jimmerson17/blanc-mask-model/Parts/BLANC.07.01 Filter Pad/Sample. View 1.jpeg

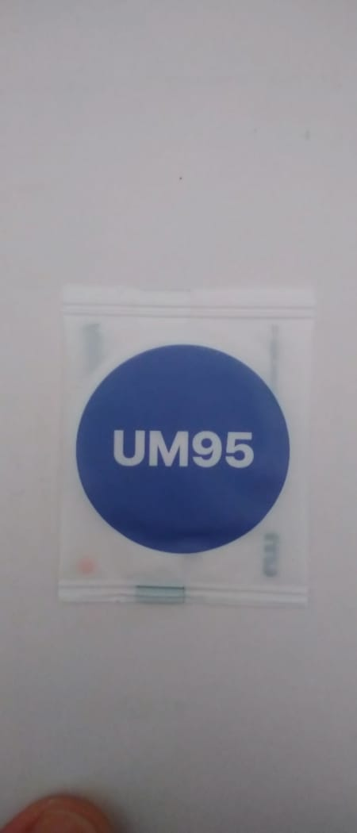
Parts/BLANC.07.01 Filter Pad/Sample. View 1.jpeg
