jimmerson17/blanc-mask-model/Product/BLANC.00.00 Blanc mask rev E.JPG

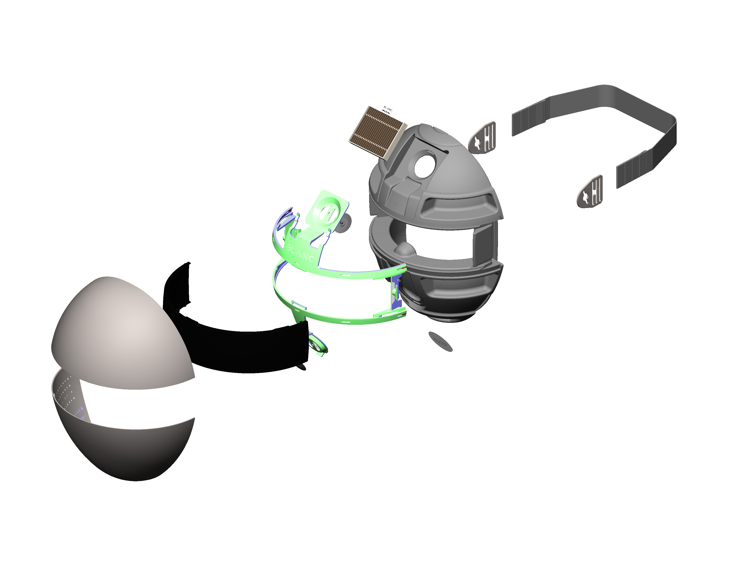
Product/BLANC.00.00 Blanc mask rev E.JPG
