jimmerson17/blanc-mask-model/Parts/BLANC.07.01 Filter Pad/Filter sample 2.jpg

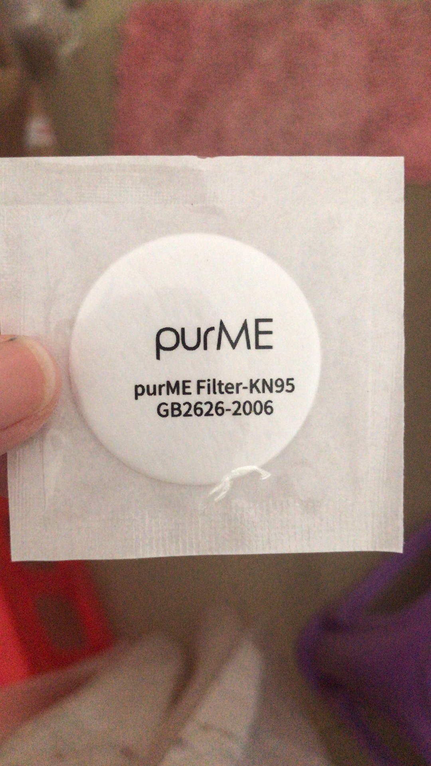
Parts/BLANC.07.01 Filter Pad/Filter sample 2.jpg
