jimmerson17/blanc-mask-model/Parts/BLANC.07.01 Filter Pad/Sample. View 2.jpeg

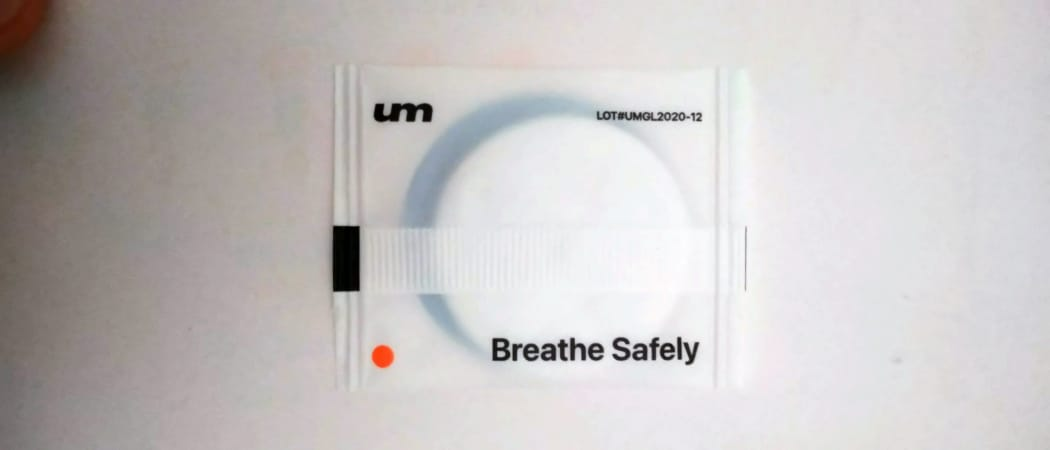
Parts/BLANC.07.01 Filter Pad/Sample. View 2.jpeg
