jimmerson17/blanc-mask-model/Parts/BLANC.02.01 Top shield/BLANC.02.01 Top shield rev F.STEP

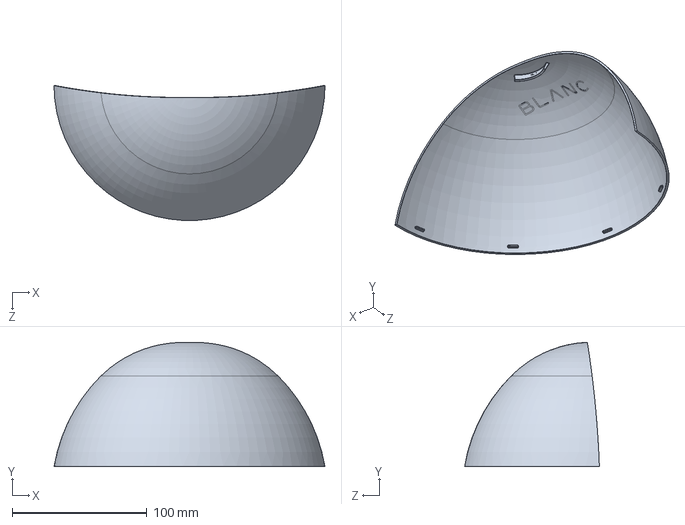
[picture p8: CAD file, 2022-05-24]
Parts/BLANC.02.01 Top shield/BLANC.02.01 Top shield rev F.STEP
201.2 x 92.4 x 100.1 mm
