jimmerson17/blanc-mask-model/Parts/BLANC.02.02 Bottom shield/BLANC.02.02 Bottom shield rev F.STEP

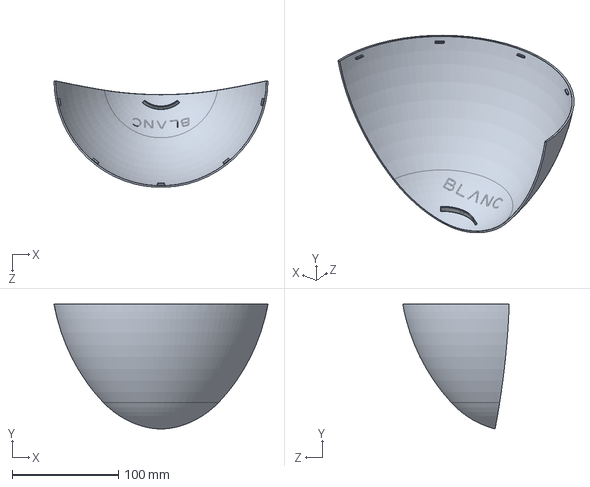
[picture p9: CAD file, 2022-05-24]
Parts/BLANC.02.02 Bottom shield/BLANC.02.02 Bottom shield rev F.STEP
201.2 x 117.4 x 100.1 mm
