jimmerson17/blanc-mask-model/Parts/BLANC.02.03 Visor/BLANC.02.03 Visor rev D.sldprt

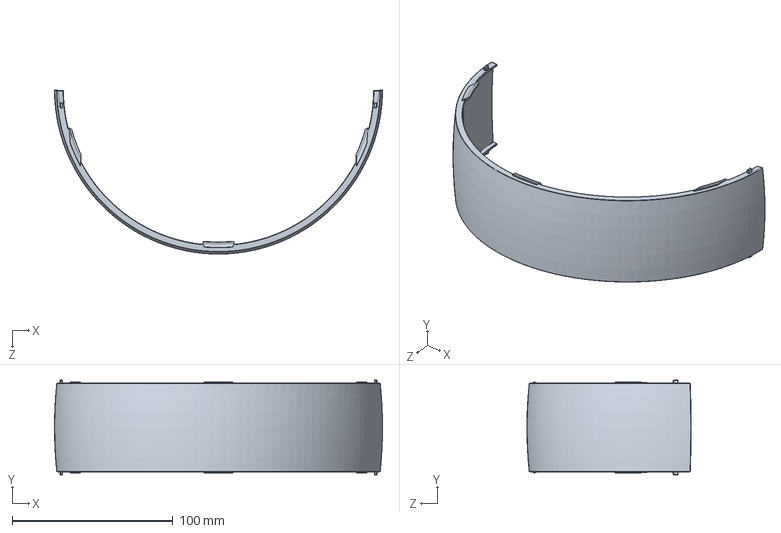
[picture p10: CAD file, 2022-05-24]
Parts/BLANC.02.03 Visor/BLANC.02.03 Visor rev D.sldprt
204.0 x 59.0 x 102.1 mm
