jimmerson17/blanc-mask-model/Parts/BLANC.03.01 Strap Holder/BLANC.03.01 Strap Holder rev D.sldprt

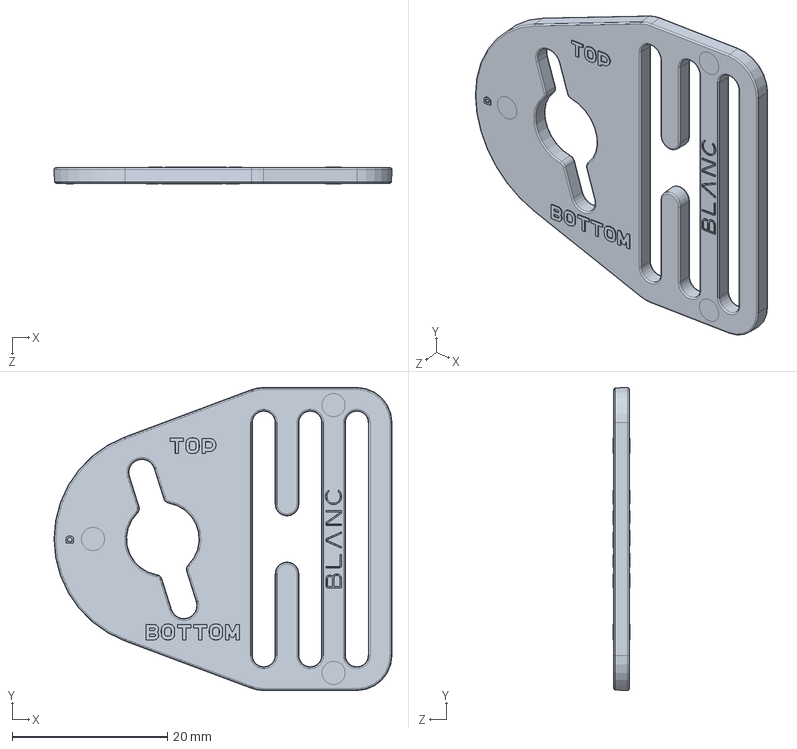
[picture p11: CAD file, 2022-05-24]
Parts/BLANC.03.01 Strap Holder/BLANC.03.01 Strap Holder rev D.sldprt
43.6 x 39.1 x 2.20 mm
