jimmerson17/blanc-mask-model/Parts/BLANC.03.02 Strap/BLANC.03.02 Strap rev C.sldprt

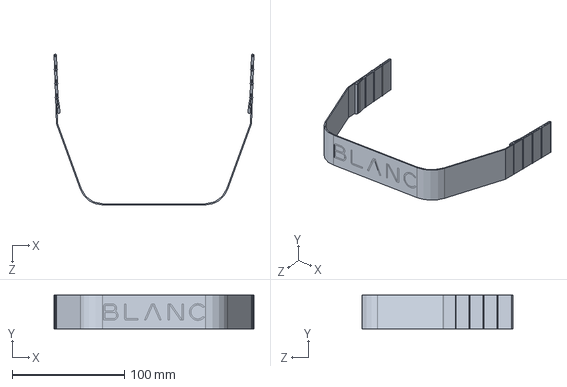
[picture p12: CAD file, 2022-05-24]
Parts/BLANC.03.02 Strap/BLANC.03.02 Strap rev C.sldprt
178.5 x 30.0 x 134.6 mm
