jimmerson17/blanc-mask-model/Parts/BLANC.04.01 Cuff/BLANC.04.01 Cuff rev H.sldprt

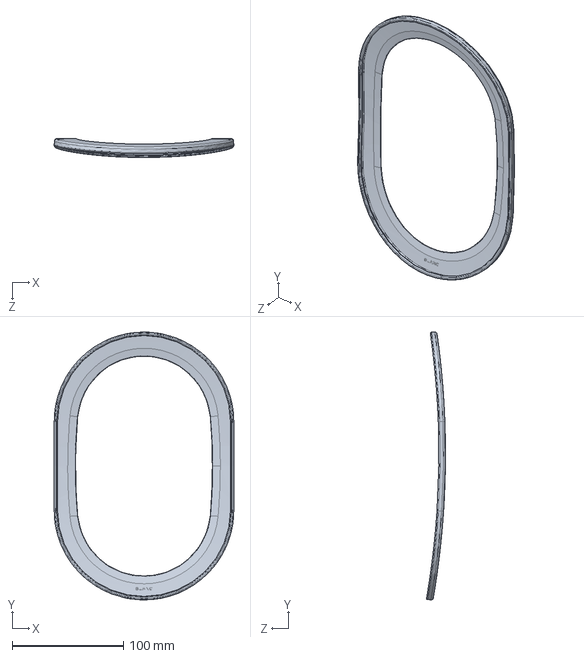
[picture p13: CAD file, 2022-05-24]
Parts/BLANC.04.01 Cuff/BLANC.04.01 Cuff rev H.sldprt
161.2 x 240.5 x 17.1 mm
