jimmerson17/blanc-mask-model/Parts/BLANC.05.01 HEPA Filter/BLANC.05.01 HEPA Filter rev C.sldprt

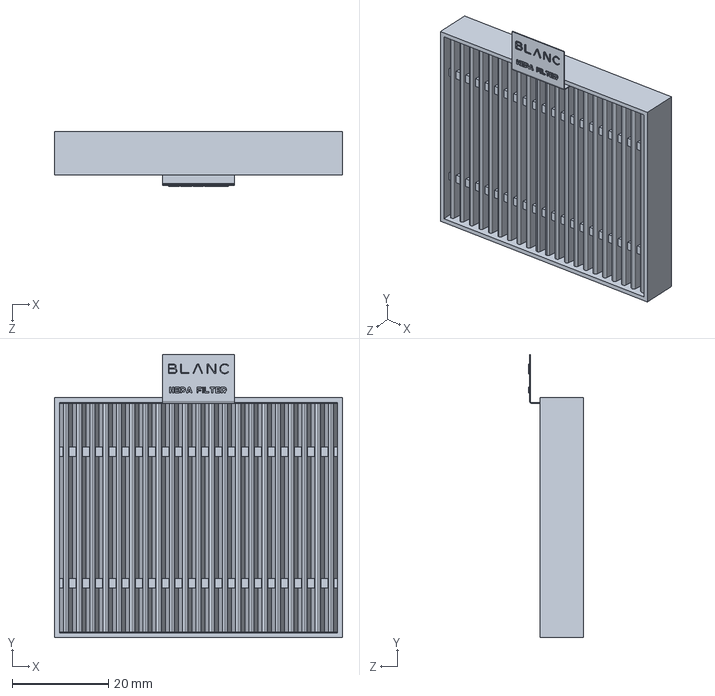
[picture p14: CAD file, 2022-05-24]
Parts/BLANC.05.01 HEPA Filter/BLANC.05.01 HEPA Filter rev C.sldprt
60.0 x 59.0 x 11.4 mm
