jimmerson17/blanc-mask-model/Parts/BLANC.06.01 Umbrella Valve/BLANC.06.01 Umbrella Valve rev D.STEP

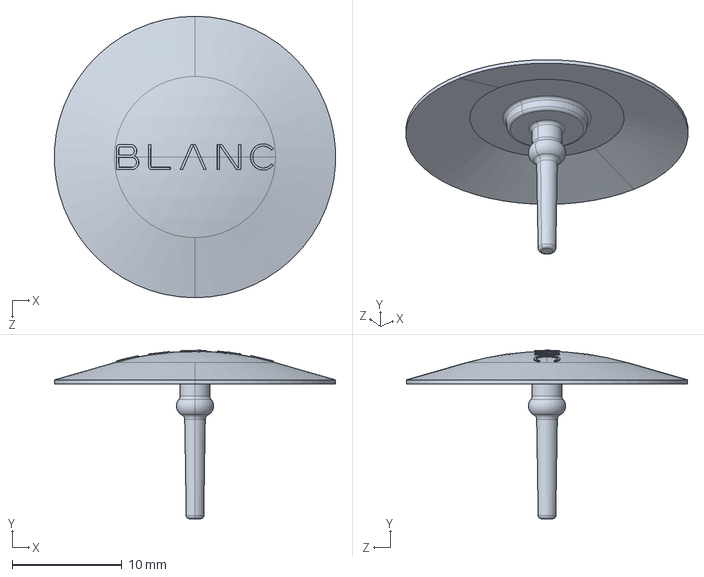
[picture p15: CAD file, 2022-05-24]
Parts/BLANC.06.01 Umbrella Valve/BLANC.06.01 Umbrella Valve rev D.STEP
25.6 x 15.3 x 25.6 mm
