jimmerson17/blanc-mask-model/(list of files, cad)

Other CAD files:
Parts/BLANC.07.01 Filter Pad/BLANC.07.01 Filter Pad. Layout 1.DWG
Parts/BLANC.02.03 Visor/BLANC.02.03 Visor rev E.STEP
Parts/BLANC.07.01 Filter Pad/BLANC.07.01 Filter Pad. Layout 2.DWG
Parts/BLANC.01.01 Body/BLANC.01.01 Body rev F.SLDDRW
Parts/BLANC.02.02 Bottom shield/BLANC.02.02 Bottom shield rev F.sldprt
Parts/BLANC.04.01 Cuff/BLANC.04.01 Cuff rev H.SLDDRW
Parts/BLANC.06.01 Umbrella Valve/BLANC.06.01 Umbrella Valve rev D.STL
Parts/BLANC.06.01 Umbrella Valve/BLANC.06.01 Umbrella Valve rev D.sldprt
Parts/BLANC.07.01 Filter Pad/BLANC.07.01 Filter Pad rev C.SLDPRT
Parts/BLANC.07.01 Filter Pad/BLANC.07.01 Filter Pad. Layout rev C.SLDDRW
