jimmerson17/blanc-mask-model/Parts/BLANC.07.01 Filter Pad/BLANC.07.01 Filter Pad. Layout 1.PDF

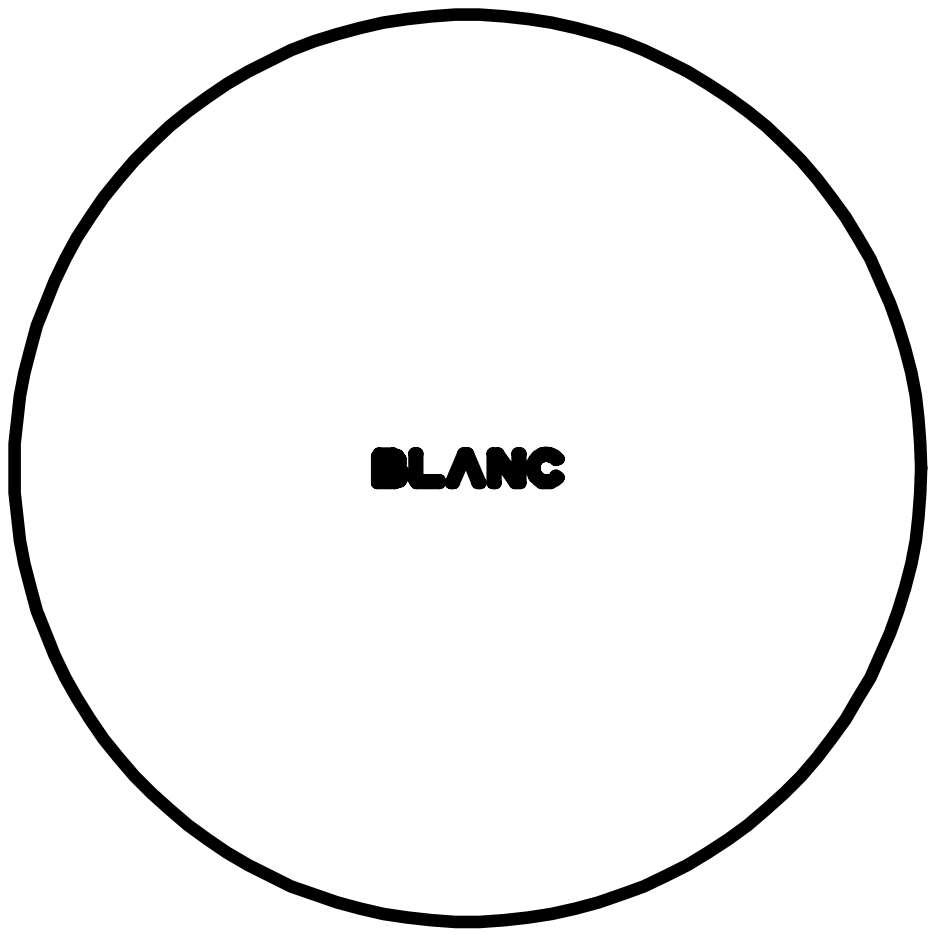
[picture p23: page 1]
