jimmerson17/blanc-mask-model/Parts/BLANC.07.01 Filter Pad/BLANC.07.01 Filter Pad. Layout 2.PDF

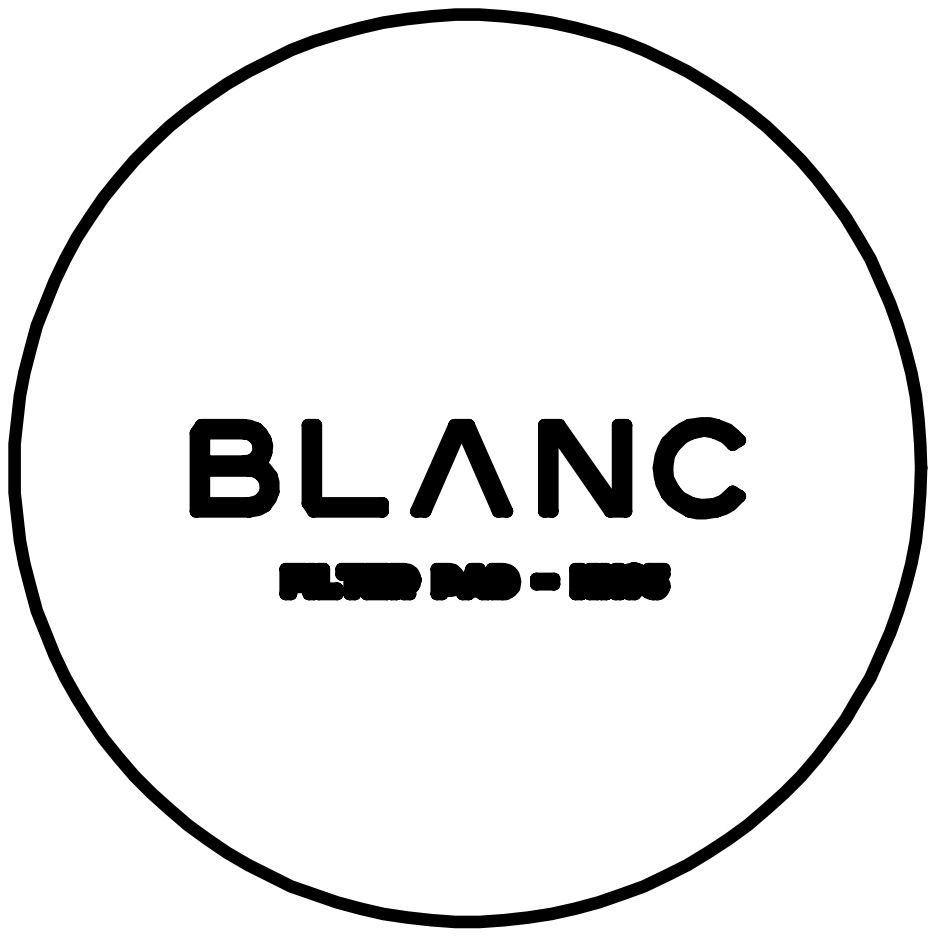
[picture p24: page 1]
