jimmerson17/blanc-mask-model/Product/BLANC.00.00 Blanc mask. Painting specificaion.pdf

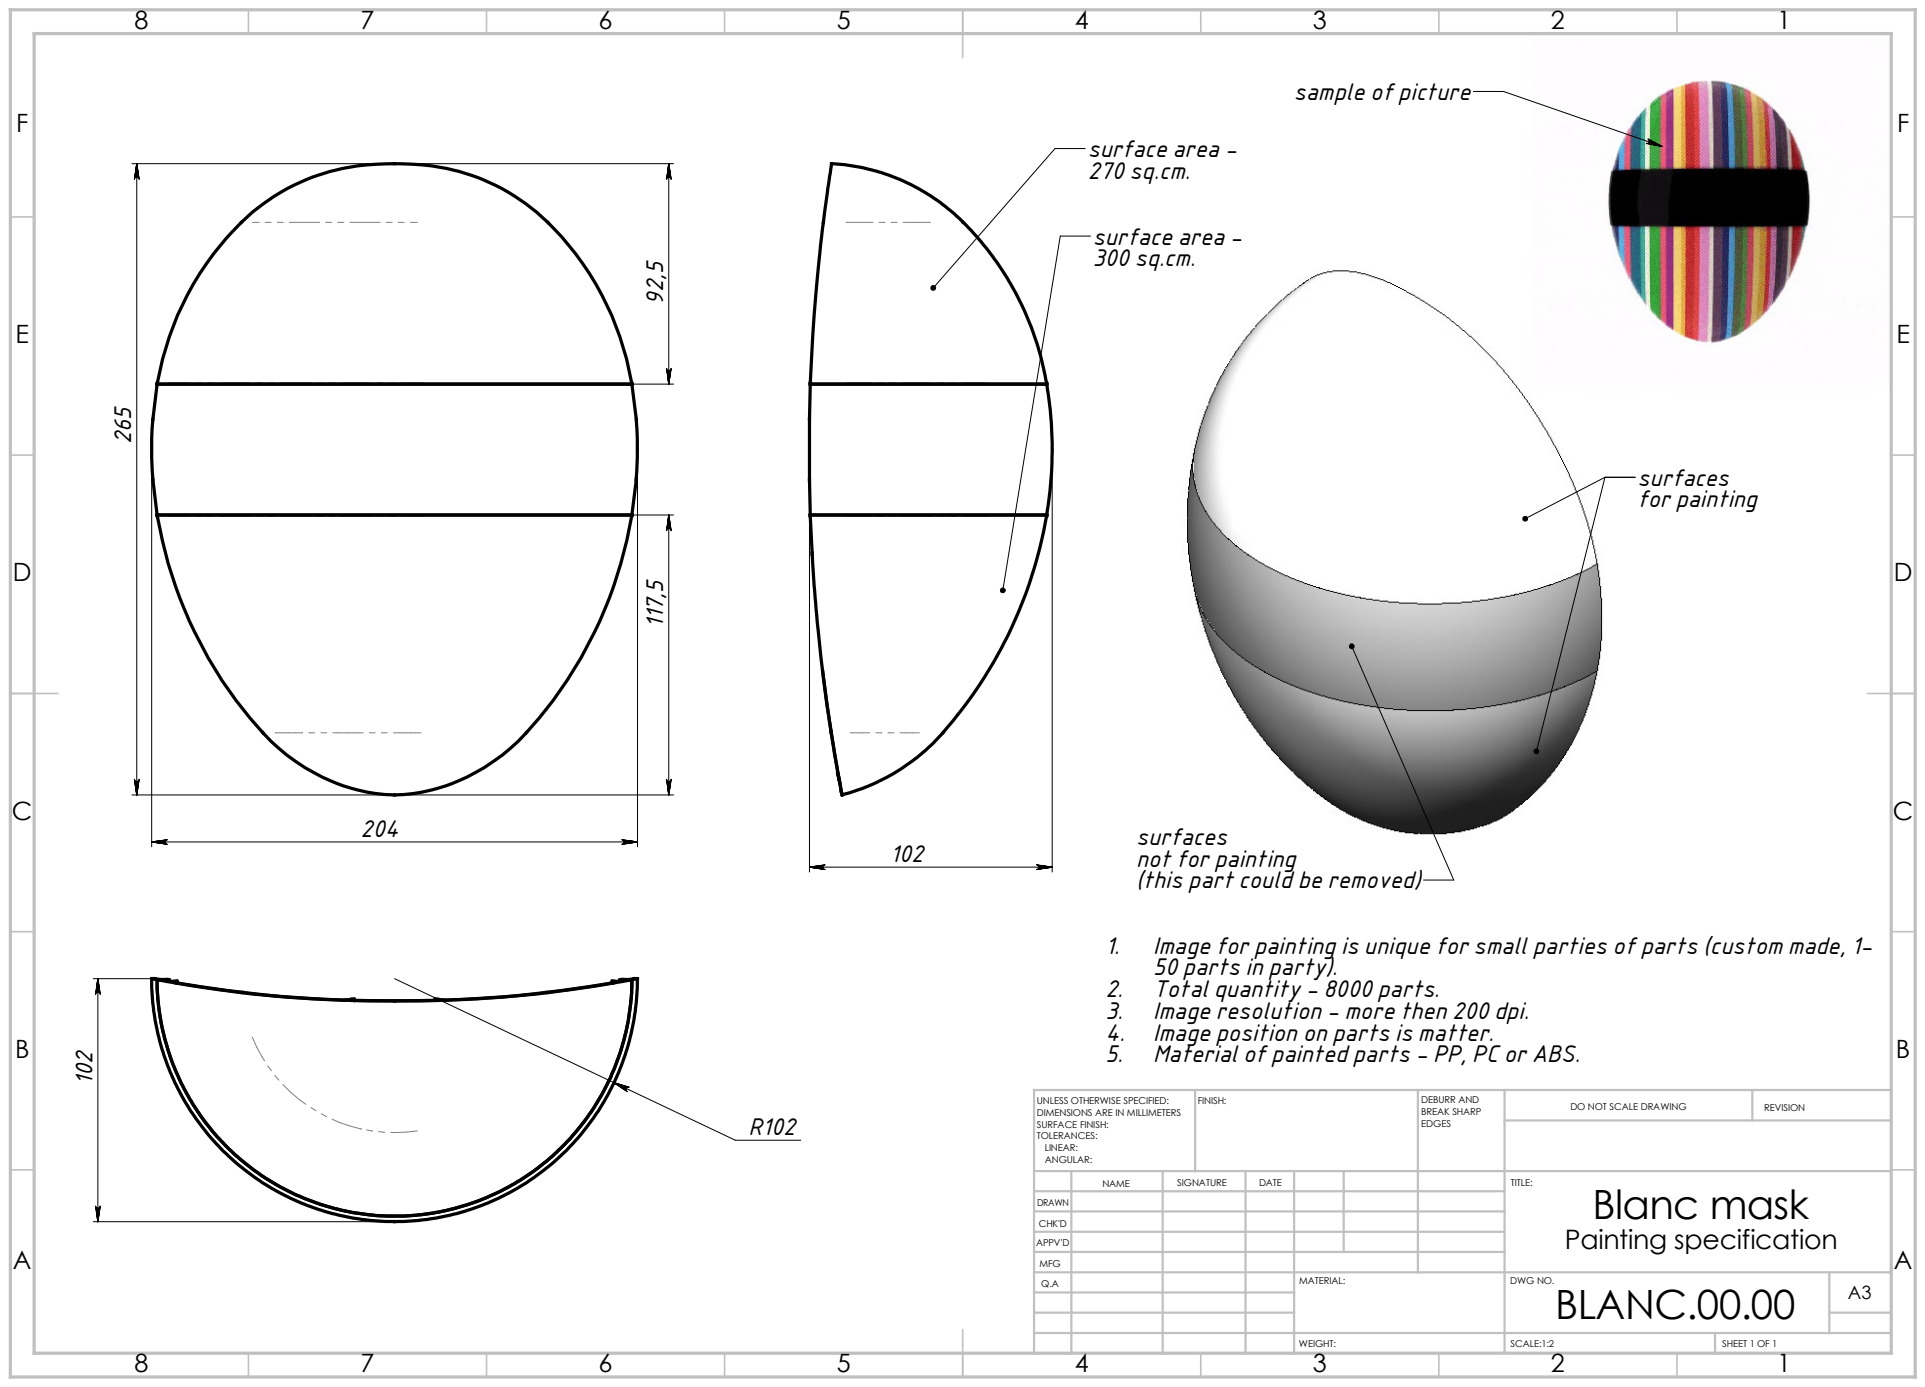
[picture p17: page 1]
102 ¹¹⁷,5 265; FINISH:; EDGES; NAME; SIGNATURE; DATE; DO NOT SCALE DRAWING; REVISION; TITLE:; SCALE:1:2; SHEET 1 OF 1; WEIGHT:; BREAK SHARP; Painting specification A A; DEBURR AND; Blanc mask; surface area - 300 sq.cm.; surface area - 270 sq.cm.; surfaces for painting

sample of picture

surfaces
not for painting
(this part could be removed)

1. Image for painting is unique for small parties of parts (custom made, 1-
50 parts in party).
2. Total quantity - 8000 parts.
3. Image resolution - more then 200 dpi.
4. Image position on parts is matter.
5. Material of painted parts - PP, PC or ABS.

UNLESS OTHERWISE SPECIFIED:
DIMENSIONS ARE IN MILLIMETERS
SURFACE FINISH:
TOLERANCES:
LINEAR:
ANGULAR:

MFG | | | | 1 DRAWN
CHK'D
APPV'D

Q.A | MATERIAL: | DWG NO. BLANC.00.00 | A3
