jimmerson17/blanc-mask-model/Parts/BLANC.01.01 Body/BLANC.01.01 Body rev F.pdf

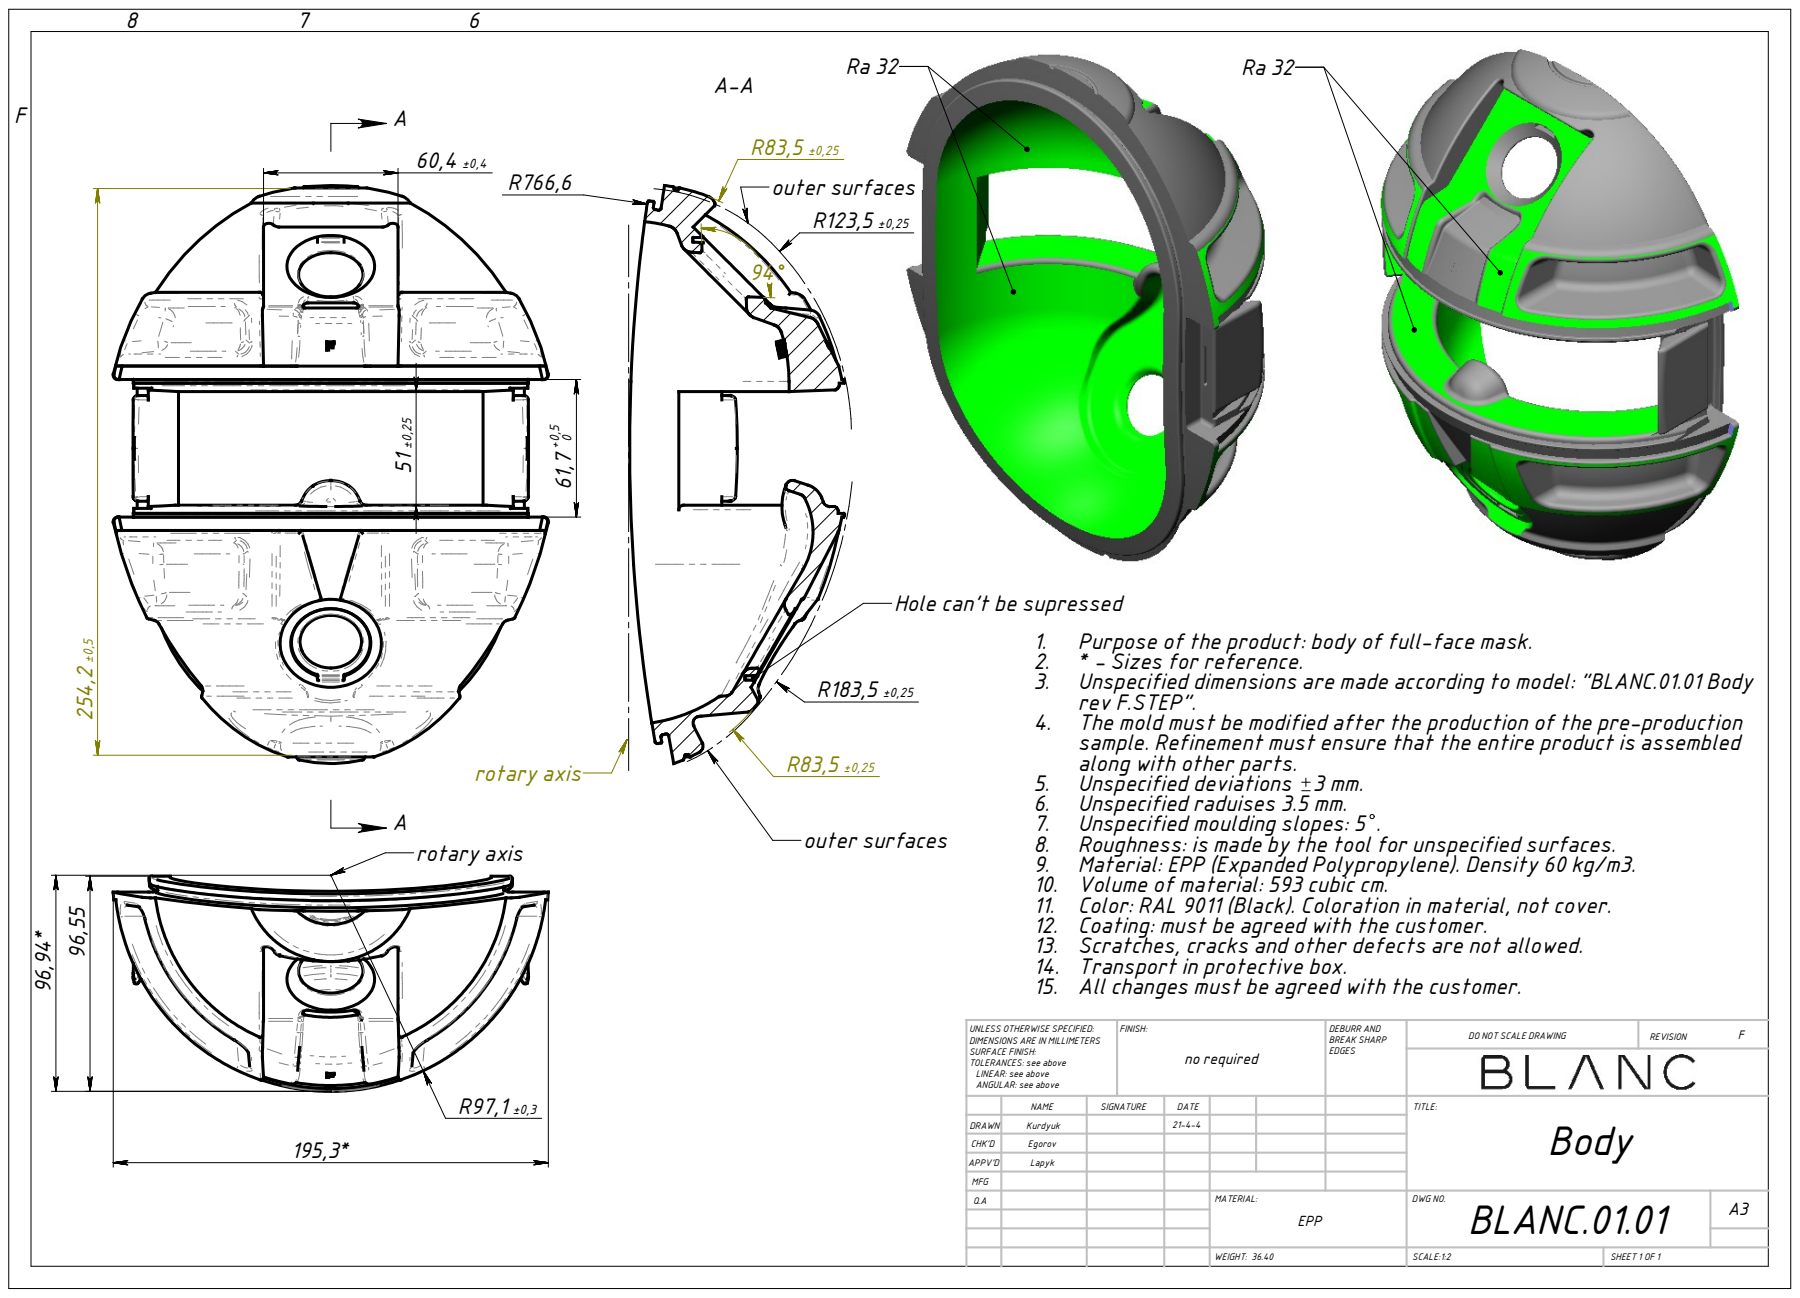
[picture p18: page 1]
WEIGHT: 36.40; FINISH:; EDGES; DO NOT SCALE DRAWING; REVISION; SCALE:1:2; SHEET 1 OF 1; no required; DEBURR AND BREAK SHARP; rotary axis; 195,3* ²⁵⁴,2 ±0,5; outer surfaces

Hole can't be supressed

1. Purpose of the product: body of full-face mask.
2. * - Sizes for reference.
3. Unspecified dimensions are made according to model: "BLANC.01.01 Body
rev F.STEP".
4. The mold must be modified after the production of the pre-production
sample. Refinement must ensure that the entire product is assembled
along with other parts.
5. Unspecified deviations 3 mm.
6. Unspecified raduises 3.5 mm.
7. Unspecified moulding slopes: 5 .
8. Roughness: is made by the tool for unspecified surfaces.
9. Material: EPP (Expanded Polypropylene). Density 60 kg/m3.
10. Volume of material: 593 cubic cm.
11. Color: RAL 9011 (Black). Coloration in material, not cover.
12. Сoating: must be agreed with the customer.
13. Scratches, cracks and other defects are not allowed.
14. Transport in protective box.
15. All changes must be agreed with the customer.

UNLESS OTHERWISE SPECIFIED:
DIMENSIONS ARE IN MILLIMETERS
SURFACE FINISH:
TOLERANCES: see above
LINEAR: see above
ANGULAR: see above

NAME | SIGNATURE | DATE | | | | TITLE: Body

DRAWN | Kurdyuk | | 21-4-4
CHK'D | Egorov
APPV'D | Lapyk
MFG
Q.A | | | | MATERIAL: EPP | DWG NO. BLANC.01.01 | A3
