jimmerson17/blanc-mask-model/Parts/BLANC.02.02 Bottom shield/BLANC.02.02 Bottom shield rev E.pdf

# Roughness scheme (color only for scheme)

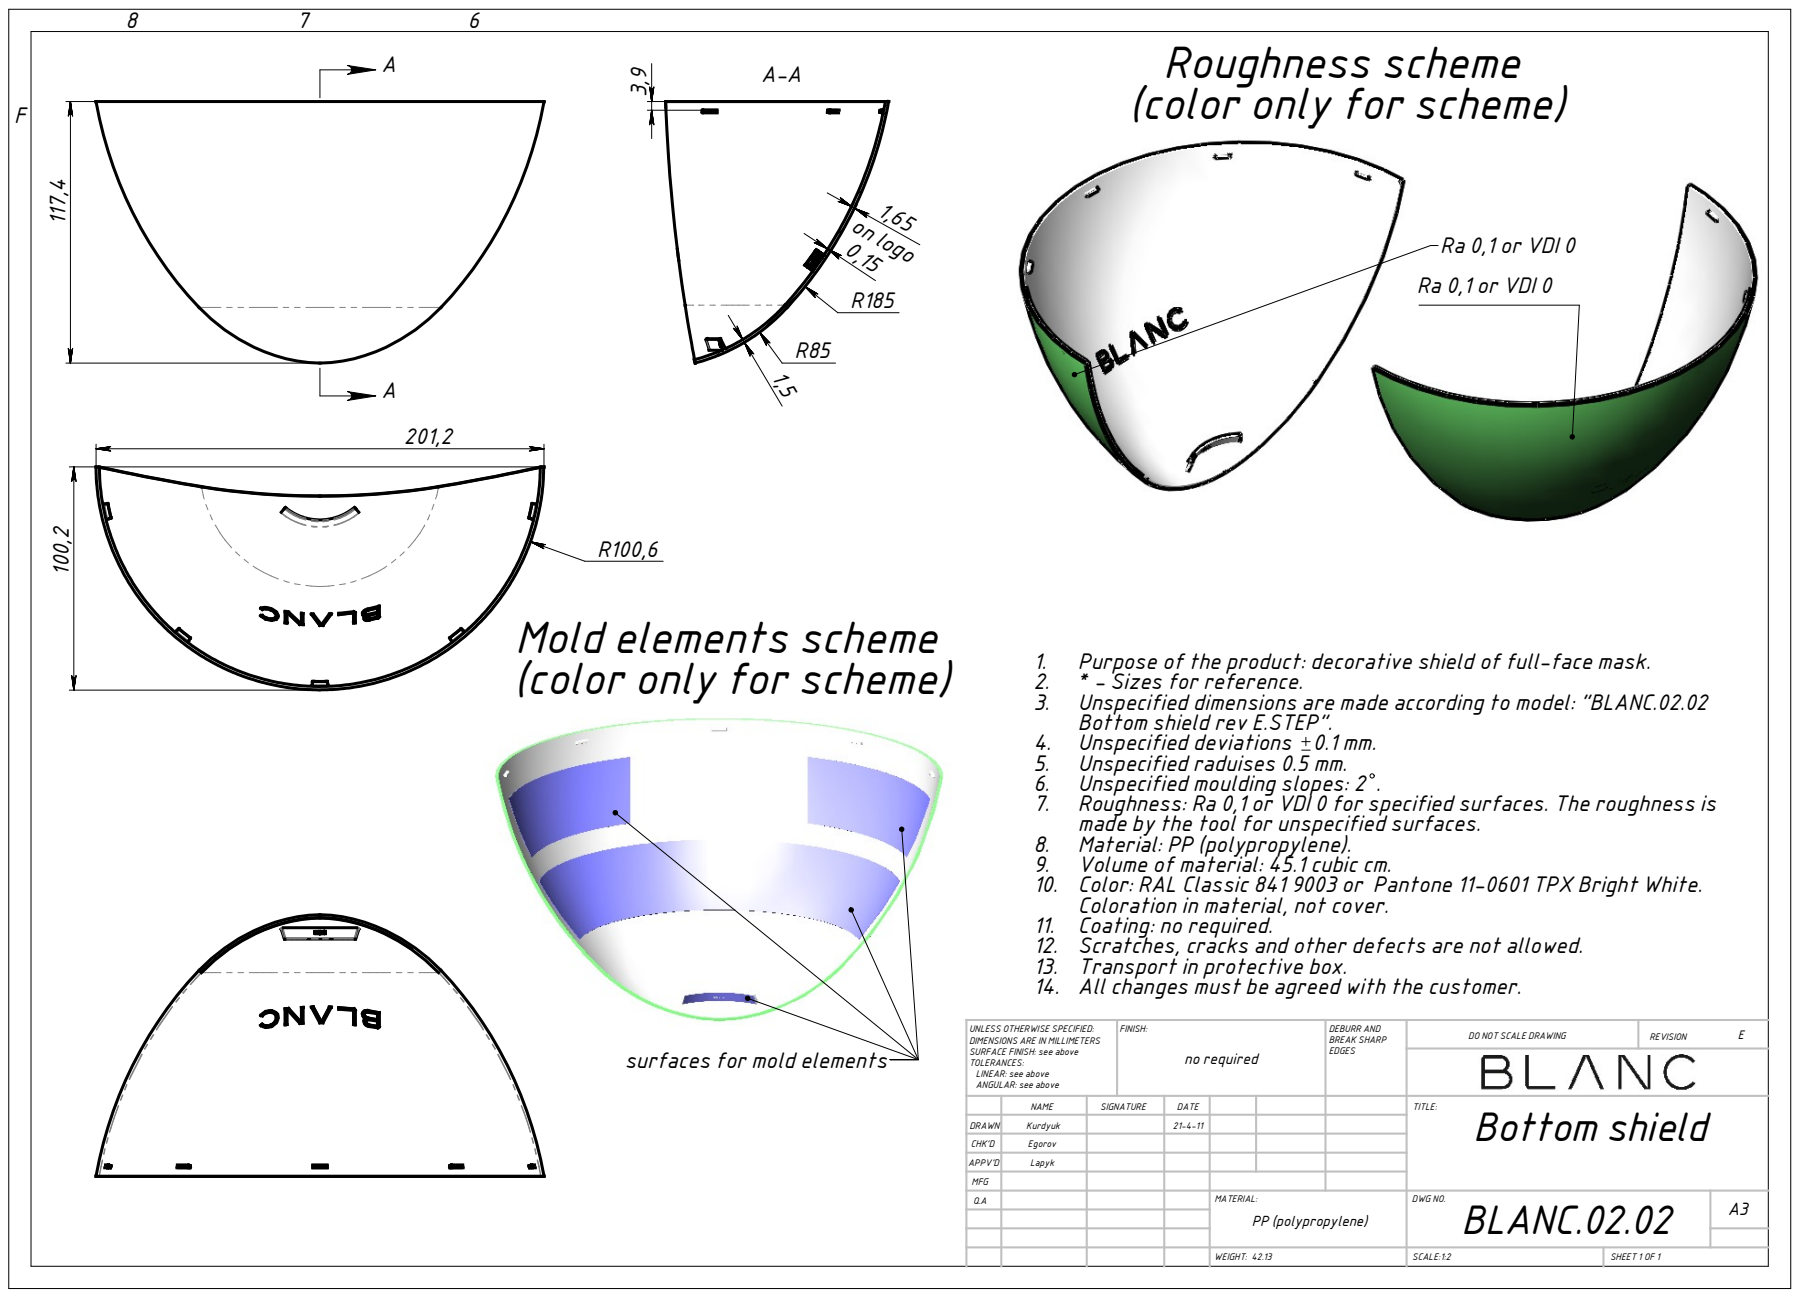
[picture p19: page 1]
FINISH:; EDGES; DO NOT SCALE DRAWING; REVISION; SCALE:1:2; SHEET 1 OF 1; no required; WEIGHT: 42.13; DEBURR AND BREAK SHARP; on logo; 4. Unspecified deviations

Ra 0,1 or VDI 0

Mold elements scheme
(color only for scheme)

1. Purpose of the product: decorative shield of full-face mask.
2. * - Sizes for reference.
3. Unspecified dimensions are made according to model: "BLANC.02.02
Bottom shield rev E.STEP".
5. Unspecified raduises 0.5 mm.
6. Unspecified moulding slopes: 2 .
7. Roughness: Ra 0,1 or VDI 0 for specified surfaces. The roughness is
made by the tool for unspecified surfaces.
8. Material: PP (polypropylene).
9. Volume of material: 45.1 cubic cm.
10. Color: RAL Classic 841 9003 or Pantone 11-0601 TPX Bright White.
Coloration in material, not cover.
11. Сoating: no required.
12. Scratches, cracks and other defects are not allowed.
13. Transport in protective box.
14. All changes must be agreed with the customer.

UNLESS OTHERWISE SPECIFIED:
DIMENSIONS ARE IN MILLIMETERS
SURFACE FINISH: see above
TOLERANCES:
LINEAR: see above
ANGULAR: see above

surfaces for mold elements

NAME | SIGNATURE | DATE | | | | TITLE: Bottom shield

DRAWN | Kurdyuk | | 21-4-11
CHK'D | Egorov
APPV'D | Lapyk
MFG
Q.A | | | | MATERIAL: PP (polypropylene) | DWG NO. BLANC.02.02 | A3
