jimmerson17/blanc-mask-model/Parts/BLANC.05.01 HEPA Filter/BLANC.05.01 HEPA Filter rev C.pdf

# label

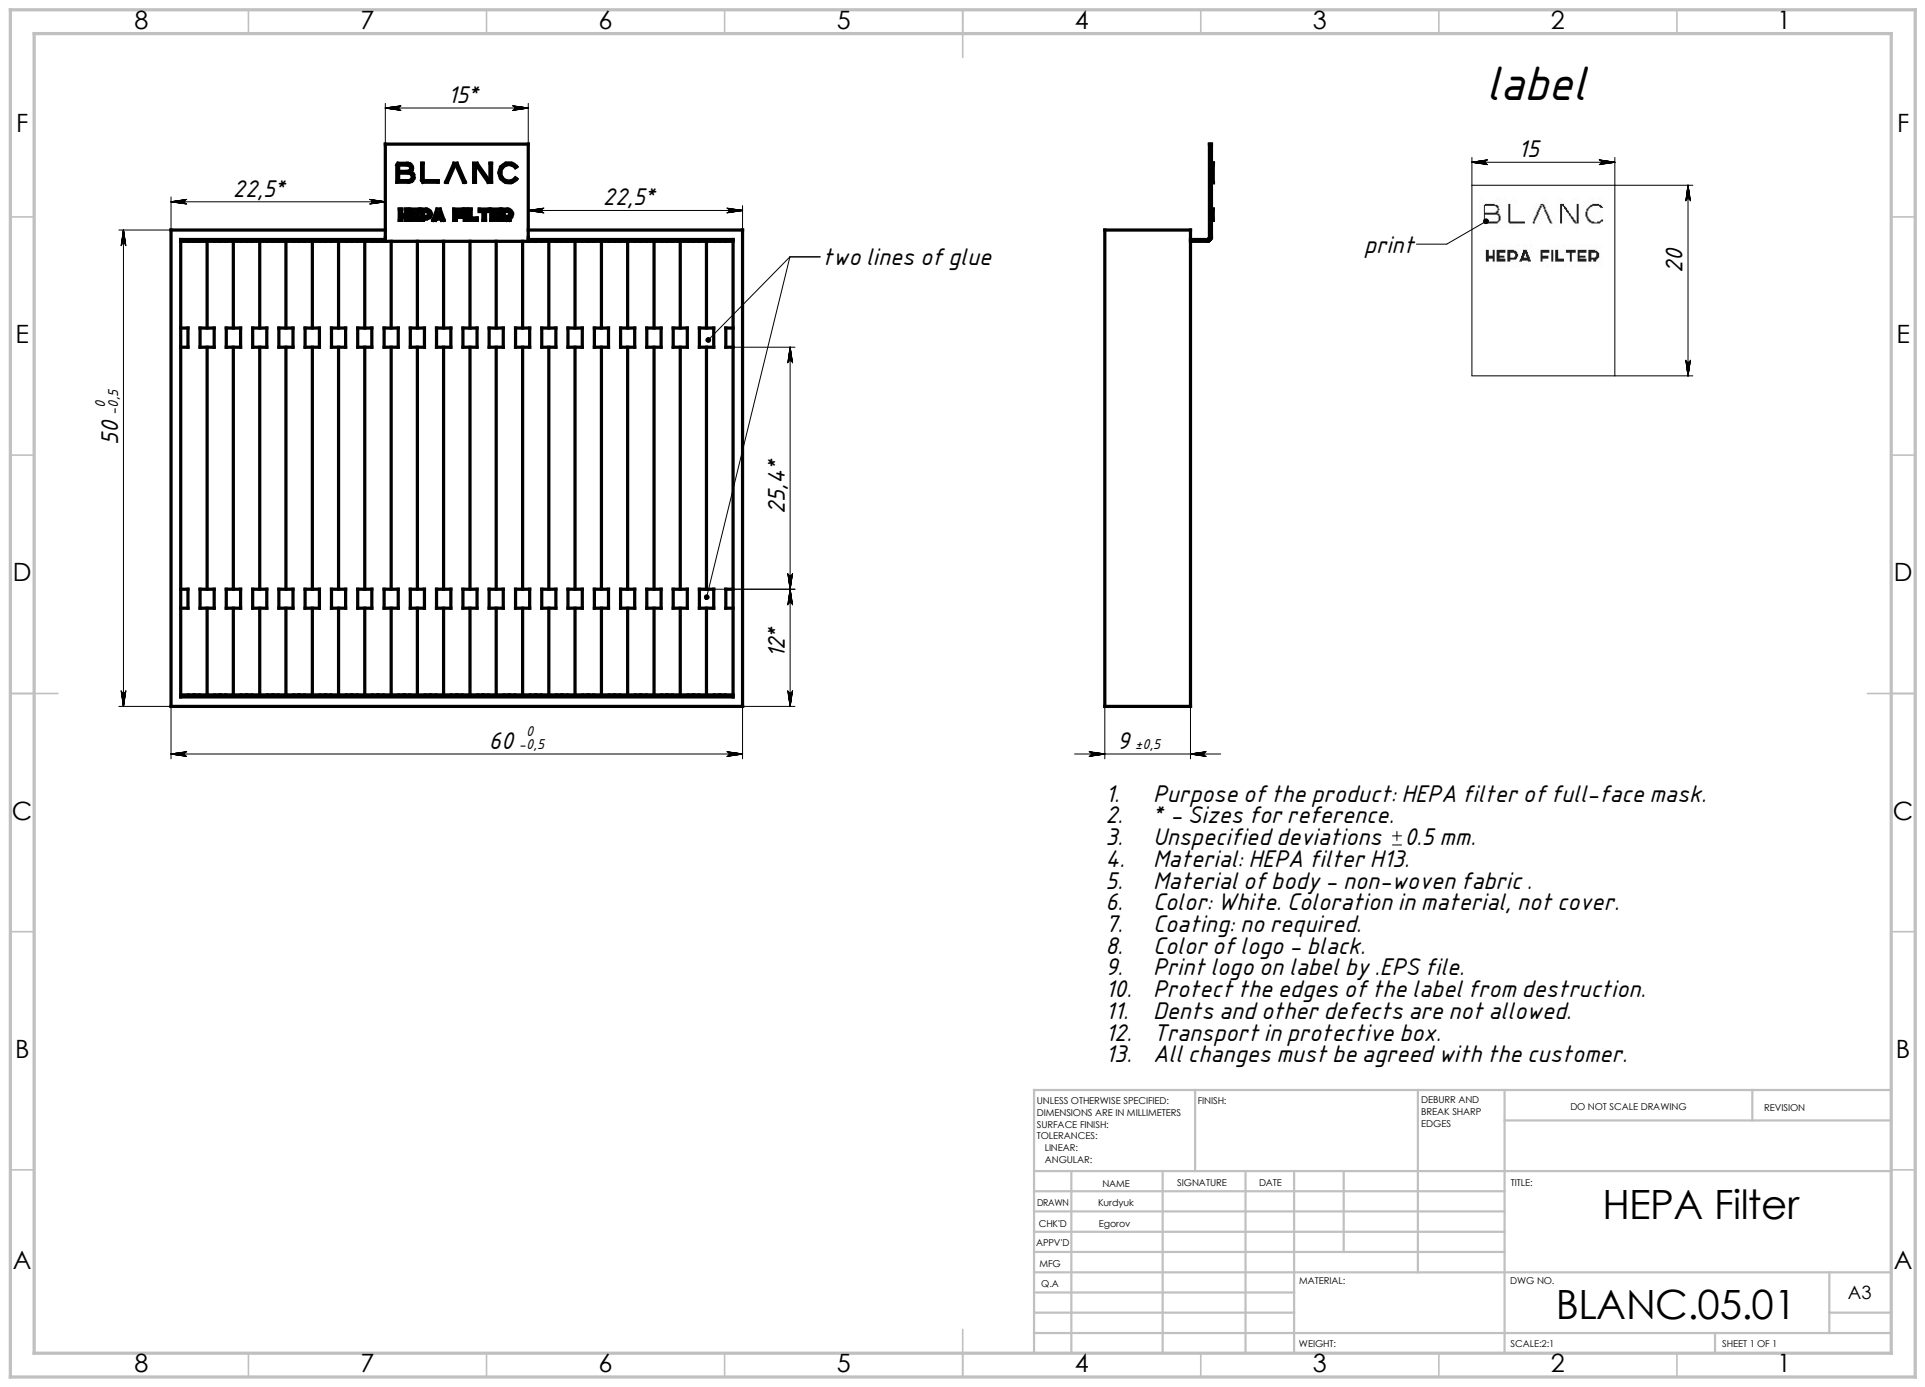
[picture p20: page 1]
FINISH:; EDGES; DO NOT SCALE DRAWING; REVISION; SCALE:2:1; SHEET 1 OF 1; WEIGHT:; DEBURR AND BREAK SHARP; 3. Unspecified deviations; print

two lines of glue 25,4*

1. Purpose of the product: HEPA filter of full-face mask.
2. * - Sizes for reference.
4. Material: HEPA filter H13.
5. Material of body - non-woven fabric .
6. Color: White. Coloration in material, not cover.
7. Сoating: no required.
8. Color of logo - black.
9. Print logo on label by .EPS file.
10. Protect the edges of the label from destruction.
11. Dents and other defects are not allowed.
12. Transport in protective box.
13. All changes must be agreed with the customer.

UNLESS OTHERWISE SPECIFIED:
DIMENSIONS ARE IN MILLIMETERS
SURFACE FINISH:
TOLERANCES:
LINEAR:
ANGULAR:

NAME | SIGNATURE | DATE | | | | TITLE: HEPA Filter
Kurdyuk

MFG | | | | | | | 1 DRAWN
CHK'D | Egorov
APPV'D

Q.A | | | | MATERIAL: | DWG NO. BLANC.05.01 | A3
