jimmerson17/blanc-mask-model/Product/BLANC.00.00 Blanc mask.pdf

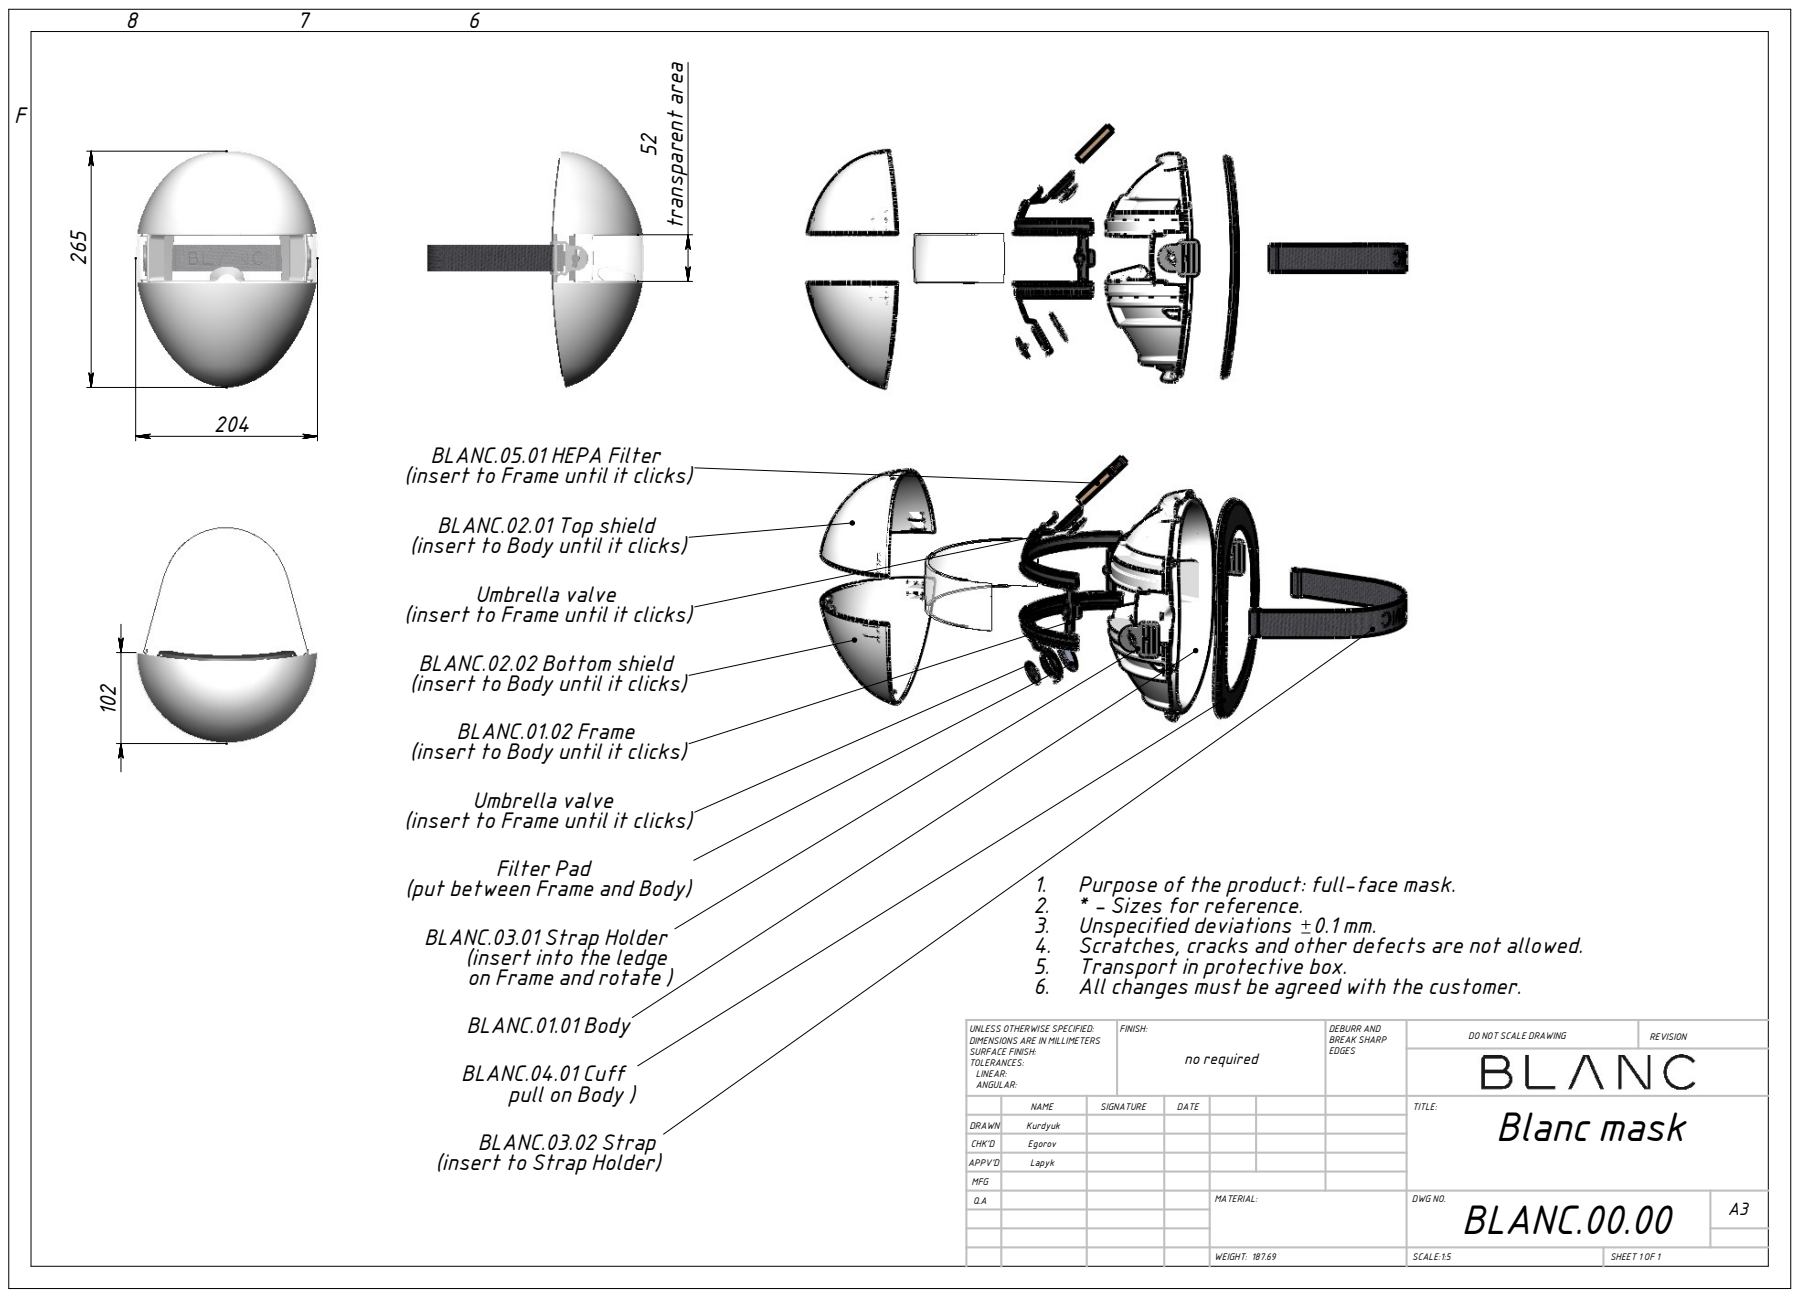
[picture p22: page 1]
52 transparent area 265; WEIGHT: 187.69; no required; SHEET 1 OF 1; FINISH:; EDGES; DO NOT SCALE DRAWING; REVISION; SCALE:1:5; DEBURR AND BREAK SHARP; 3. Unspecified deviations; Filter Pad

BLANC.05.01 HEPA Filter
(insert to Frame until it clicks)
BLANC.02.01 Top shield
(insert to Body until it clicks)
Umbrella valve
BLANC.02.02 Bottom shield
BLANC.01.02 Frame

1. Purpose of the product: full-face mask.
2. * - Sizes for reference.
4. Scratches, cracks and other defects are not allowed.
5. Transport in protective box.
6. All changes must be agreed with the customer.

(put between Frame and Body)
BLANC.03.01 Strap Holder
(insert into the ledge
on Frame and rotate )
BLANC.01.01 Body
BLANC.04.01 Cuff
pull on Body )
BLANC.03.02 Strap
(insert to Strap Holder)

UNLESS OTHERWISE SPECIFIED:
DIMENSIONS ARE IN MILLIMETERS
SURFACE FINISH:
TOLERANCES:
LINEAR:
ANGULAR:

NAME | SIGNATURE | DATE | | | | TITLE: Blanc mask

DRAWN | Kurdyuk
CHK'D | Egorov
APPV'D | Lapyk
MFG
Q.A | | | | MATERIAL: | DWG NO. BLANC.00.00 | A3
